Swatantara21/Bulk_Encryptor/README.md

# Bulk_Encryptor
Contributors:
Madhav P. Desai
Anshul Gupta
Swatantara Chakraborty

Try to get this goddamned piece of crap into 
some reasonable shape.

All stuff is placed in reoorg.
