Swatantara21/Bulk_Encryptor/riffa_testbench/test_threads2/readme.txt

riffa testbench :
creats two threads, one supplies two 64-bits inputs numWords times
and other recieves two 64-bits output numWords times.
numWords is given while running the executable "testutil"
