Swatantara21/Bulk_Encryptor/riffa_testbench/readme.txt

This folder contains riffa testbenches..
