Swatantara21/Bulk_Encryptor/Aes-Reorg/riffa_testbench/readme.txt

aes_avs_test/

	A testbench which checks the AESAVS from NIST on
	our implementation.
