Swatantara21/Bulk_Encryptor/riffa_testbench/test_apps/readme.txt

riffa testbench by riffa creators.
for bandwidth tests on fpga
