Swatantara21/Bulk_Encryptor/Aes-Reorg/riffa_testbench/aes_avs_test/readme.txt

riffa testbench :
supplies two 64-bit inputs and recieves of two 64-bits output serially numWords times.
numWords is given while running the executable "testutil"
