Swatantara21/Bulk_Encryptor/aes_blocks/e_block_volatile/test_result.txt

3ad78e726c1ec02b 7ebfe92b23d9ec34
aae5939c8efdf2f0 4e60b9fe7117b2c2
f031d4d74f5dcbf3 9daaf8ca3af6e527
96d9fd5cc4f07441 727df0f33e401a36
30ccdb044646d7e1 f3ccea3dca08b8c0
16ae4ce5042a67ee 8e177b7c587ecc82
b6da0bb11a23855d 9c5cb1b4c6412e0a
db4f1aa530967d67 32ce4715eb0ee24b
a81738252621dd18  a34f3455b4baa2f
77e2b508db7fd892 34caf7939ee5621a
b8499c251f8442ee 13f0933b688fcd19
965135f8a81f25c9 d630b17502f68e53
8b87145a01ad1c6c ede995ea3670454f
8eae3b10a0c8ca6d 1d3b0fa61e56b0b2
64b4d629810fda6b afdf08f3b0d8d2c5
