Swatantara21/Bulk_Encryptor/Aes-Reorg/aes_engine/Aa/testbench_mc.txt

#include <signal.h>
#include <stdio.h>
#include <stdlib.h>
#include <stdint.h>
#include <pthread.h>
#include <pthreadUtils.h>
#include <Pipes.h>
#include <pipeHandler.h>
#ifndef SW
#include "vhdlCStubs.h"
#endif

#define ORDER 128

uint64_t sent_values[2];
uint64_t cmd_values[3];
void Exit(int sig)
{
	fprintf(stderr, "## Break! ##\n");
	exit(0);
}

void SenderCmd()
{
	int idx,jdx,k;
	cmd_values[0] = 0x880000000000000a;
	cmd_values[1] = 0x0000000000000000;
	cmd_values[2] = 0x0000000000000000;
	
	write_uint64_n("cmd_in",cmd_values,3);
	fprintf(stderr,"\ncmd: %16lx key:%16lx %16lx",cmd_values[0],cmd_values[1],cmd_values[2]);
	
	cmd_values[0] = 0x880000000000002a;
	cmd_values[1] = 0x0000000000000000;
	cmd_values[2] = 0x0000000000000001;
	write_uint64_n("cmd_in",cmd_values,3);
	fprintf(stderr,"\ncmd: %16lx key:%16lx %16lx",cmd_values[0],cmd_values[1],cmd_values[2]);
	
}

void Sender()
{
	int idx,jdx,k;
	k=0;
	sent_values[0] = 0x8000000000000000;
	sent_values[1] = 0x0000000000000000;
	
	write_uint64_n("in_data",sent_values,2);
	fprintf(stderr,"\nPT: %16lx %16lx",sent_values[0],sent_values[1]);
	
	for(idx = 1; idx < ORDER; idx++)
	{	
		if(sent_values[k]==0xffffffffffffffff){
			k++;
			sent_values[k]= 0x8000000000000000;
		}
		else
			sent_values[k] = sent_values[k]|(sent_values[k]/2);
			
		write_uint64_n("in_data",sent_values,2);
		fprintf(stdout,"\nPT: %d: %16lx %16lx",idx,sent_values[0],sent_values[1]);
	}
	
}

void RecvStatus(){
	uint64_t status;
	while (1){
	status = read_uint64("status_out");
	fprintf(stdout,"\nstatus: %16lx\n", status);
	}
}

DEFINE_THREAD(Sender)
DEFINE_THREAD(SenderCmd)
DEFINE_THREAD(RecvStatus)

int main(int argc, char* argv[])
{	
	uint64_t result[2];
	signal(SIGINT,  Exit);
  	signal(SIGTERM, Exit);

	PTHREAD_DECL(RecvStatus);
	PTHREAD_CREATE(RecvStatus);

	int i,j,idx, jdx;
	
	cmd_values[0] = 0x880000000000000a;
	cmd_values[1] = 0x8d2e60365f17c7df;
	cmd_values[2] = 0x1040d7501b4a7b5a;
	
	sent_values[0] = 0x59b5088e6dadc3ad;
	sent_values[1] = 0x5f27a460872d5929;
	
	for (i=0; i<5; i++){
		fprintf(stderr,"cmd: %16lx key:%16lx %16lx\n",cmd_values[0],cmd_values[1],cmd_values[2]);
		fprintf(stdout,"\nPT: %d: %16lx %16lx",idx,sent_values[0],sent_values[1]);
		write_uint64_n("cmd_in",cmd_values,3);
	
		for (j=0; j<10; j++){
			write_uint64_n("d_in_data",sent_values,2);
			read_uint64_n("d_out_data",result,2);
			sent_values[0] = result[0];
			sent_values[1] = result[1];
		}
		fprintf(stdout,"\nCT: %d: %16lx%16lx",idx, result[0],result[1]);
		cmd_values[1] = cmd_values[1] ^ result[0];
		cmd_values[2] = cmd_values[0] ^ result[1];
	}
		
	PTHREAD_CANCEL(RecvStatus);
	return(0);
}
