Swatantara21/Bulk_Encryptor/c_aes/decryption/KAT2/aa_result_ch512.txt

7636b952aea4d79f16d5cc3f05fdc0fa
883816ecc11a3eff710036994f8a34f3
0e384f0ea9d1bae775bf35cb768d07ff
3f458867758e0fe51cbb01df9d02817b
6e30570bfe38a2c10f8439f3ef09974b
59e070209e79ff04d712f8f2b3e90dba
b74689f5de03072cd42e12711c321c79
5e6117ee1740769bd94dc84cfd1e081b
c5ac0a45c9a74d8d039bb3d4c9c087c4
e8b694c777a9885e62f583503a543eda
514572af03f1c0657bc952b73c4867af
2c0bcc4a2590ecccf3bf8e58e3b78cab
4a3bf1e096c174dc6c44a0a2e2478f21
a4558821e514467705cb8f6e59dde874
c27f4370aa8a854888a9898030469665
ebb905da478a62753c4cc469732ba1b9
a86ab86bb6ddf3b7680bd1fefd4622fc
8d3b04adf60d6b08e94c79246ed0f092
c2c335e4ec32cc90245a17d8812a0874
fc11699a3bd24236e860e682b0b83c51
1cdd389b25f4b9d7ee3196f4abe3ca05
90f45b62e085c20c375b40df811ce9f6
9913a19415809f45fa6ea4a642c09a25
6dc85c175ce262f807adde557b4bdd48
9cf519ba3fdd180098ba9a172dc7ff60
22f69a38f3dde85e1f0a0b61ecd9cc0e
a1ba632631f2697c3190c3ae5f01c938
a4c331b446a9a065257a0e17a62e3332
f73d74aa2733cee2c71fb01679eb3729
db49f30395736abe7794470f616867e6
95bdca13354c0602139052a68e8f0b63
9e8bcbc935b23f4110957eb237103040
65367f0daaf61bb7951977422f8f9cd2
5b0dee708b299485db85995259e7a9f1
310c7d74ca3395ecca4df26118342bc3
29734d6b167c314f308098a2bf8cf85c
bb841748a574f579c26d6b9764bd14e8
79fcfecebf4d9326cc0a159183dde541
c02128f3ba397b3817ed737bc9d158bb
76fc64a8ba88d947928192f6d79440e9
68b18496793bd9ad097ffbfc40515a17
7c3d44099bf62e4117156a0945852068
83490d2b32c22085f7f694273fa1ae3a
53bb619830e22c943758cebf6e3a8f9d
08bdf0c088fe549b1d0a256737e7c3dc
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
ab975a6e0e7944bbcd4375392f3bb61e
c0956776d400a1aec02e317553035bd8
d38ef6a5a6120fbc3c5290145c2e75de
1513dda91244abb0511e64f53b6e57fa
09340b8073dfbd03cf9664a801831a64
cdef9e2a34f2a8b40468165f429d4466
6aae85d60d8193314e2f4ee761e538e9
0e14ecf1d401daf978f807bfcb8beb0e
726f79b49a1d8f0f0937b42338d22b9c
