Swatantara21/Bulk_Encryptor/Aes-Reorg/bitfilegen/tcl250/.Xil/PCIeGen1x8If64_propImpl.xdc

set_property SRC_FILE_INFO {cfile:/home/anshul/Aes-Reorg/bitfilegen/ip/pcie_core/source/PCIeGen1x8If64-PCIE_X0Y0.xdc rfile:../../ip/pcie_core/source/PCIeGen1x8If64-PCIE_X0Y0.xdc id:1 order:EARLY scoped_inst:inst} [current_design]
set_property src_info {type:SCOPED_XDC file:1 line:79 export:INPUT save:INPUT read:READ} [current_design]
set_property LOC GTXE2_CHANNEL_X0Y7 [get_cells {inst/gt_top_i/pipe_wrapper_i/pipe_lane[0].gt_wrapper_i/gtx_channel.gtxe2_channel_i}]
set_property src_info {type:SCOPED_XDC file:1 line:81 export:INPUT save:INPUT read:READ} [current_design]
set_property LOC GTXE2_CHANNEL_X0Y6 [get_cells {inst/gt_top_i/pipe_wrapper_i/pipe_lane[1].gt_wrapper_i/gtx_channel.gtxe2_channel_i}]
set_property src_info {type:SCOPED_XDC file:1 line:83 export:INPUT save:INPUT read:READ} [current_design]
set_property LOC GTXE2_CHANNEL_X0Y5 [get_cells {inst/gt_top_i/pipe_wrapper_i/pipe_lane[2].gt_wrapper_i/gtx_channel.gtxe2_channel_i}]
set_property src_info {type:SCOPED_XDC file:1 line:85 export:INPUT save:INPUT read:READ} [current_design]
set_property LOC GTXE2_CHANNEL_X0Y4 [get_cells {inst/gt_top_i/pipe_wrapper_i/pipe_lane[3].gt_wrapper_i/gtx_channel.gtxe2_channel_i}]
set_property src_info {type:SCOPED_XDC file:1 line:87 export:INPUT save:INPUT read:READ} [current_design]
set_property LOC GTXE2_CHANNEL_X0Y3 [get_cells {inst/gt_top_i/pipe_wrapper_i/pipe_lane[4].gt_wrapper_i/gtx_channel.gtxe2_channel_i}]
set_property src_info {type:SCOPED_XDC file:1 line:89 export:INPUT save:INPUT read:READ} [current_design]
set_property LOC GTXE2_CHANNEL_X0Y2 [get_cells {inst/gt_top_i/pipe_wrapper_i/pipe_lane[5].gt_wrapper_i/gtx_channel.gtxe2_channel_i}]
set_property src_info {type:SCOPED_XDC file:1 line:91 export:INPUT save:INPUT read:READ} [current_design]
set_property LOC GTXE2_CHANNEL_X0Y1 [get_cells {inst/gt_top_i/pipe_wrapper_i/pipe_lane[6].gt_wrapper_i/gtx_channel.gtxe2_channel_i}]
set_property src_info {type:SCOPED_XDC file:1 line:93 export:INPUT save:INPUT read:READ} [current_design]
set_property LOC GTXE2_CHANNEL_X0Y0 [get_cells {inst/gt_top_i/pipe_wrapper_i/pipe_lane[7].gt_wrapper_i/gtx_channel.gtxe2_channel_i}]
set_property src_info {type:SCOPED_XDC file:1 line:101 export:INPUT save:INPUT read:READ} [current_design]
set_property LOC PCIE_X0Y0 [get_cells inst/pcie_top_i/pcie_7x_i/pcie_block_i]
set_property src_info {type:SCOPED_XDC file:1 line:106 export:INPUT save:INPUT read:READ} [current_design]
set_property LOC RAMB36_X4Y34 [get_cells {inst/pcie_top_i/pcie_7x_i/pcie_bram_top/pcie_brams_rx/brams[0].ram/use_tdp.ramb36/genblk*.bram36_tdp_bl.bram36_tdp_bl}]
set_property src_info {type:SCOPED_XDC file:1 line:107 export:INPUT save:INPUT read:READ} [current_design]
set_property LOC RAMB36_X4Y33 [get_cells {inst/pcie_top_i/pcie_7x_i/pcie_bram_top/pcie_brams_rx/brams[1].ram/use_tdp.ramb36/genblk*.bram36_tdp_bl.bram36_tdp_bl}]
set_property src_info {type:SCOPED_XDC file:1 line:108 export:INPUT save:INPUT read:READ} [current_design]
set_property LOC RAMB36_X4Y31 [get_cells {inst/pcie_top_i/pcie_7x_i/pcie_bram_top/pcie_brams_tx/brams[0].ram/use_tdp.ramb36/genblk*.bram36_tdp_bl.bram36_tdp_bl}]
set_property src_info {type:SCOPED_XDC file:1 line:109 export:INPUT save:INPUT read:READ} [current_design]
set_property LOC RAMB36_X4Y30 [get_cells {inst/pcie_top_i/pcie_7x_i/pcie_bram_top/pcie_brams_tx/brams[1].ram/use_tdp.ramb36/genblk*.bram36_tdp_bl.bram36_tdp_bl}]
