Swatantara21/Bulk_Encryptor/Aes-Reorg/bitfilegen/tcl250/.Xil/Vivado-4576-AJIT6/realtime/PCIeGen1x8If64_synth.xdc

set_property SRC_FILE_INFO {cfile:/home/anshul/fpga/bitfilegeneration/ip/pcie_core/synth/PCIeGen1x8If64_ooc.xdc rfile:../../../../ip/pcie_core/synth/PCIeGen1x8If64_ooc.xdc id:1 order:EARLY scoped_inst:inst} [current_design]
set_property SRC_FILE_INFO {cfile:/home/anshul/fpga/bitfilegeneration/ip/pcie_core/source/PCIeGen1x8If64-PCIE_X0Y0.xdc rfile:../../../../ip/pcie_core/source/PCIeGen1x8If64-PCIE_X0Y0.xdc id:2 order:EARLY scoped_inst:inst} [current_design]
set_property src_info {type:TCL file:{} line:-1 export:INPUT save:INPUT read:READ} [current_design]
set_property DONT_TOUCH true [get_cells inst]
set_property src_info {type:SCOPED_XDC file:1 line:60 export:INPUT save:INPUT read:FILTER_OUT_OF_CONTEXT} [current_design]
create_clock -period 10.000 -name PCIeGen1x8If64_sys_clk [get_ports sys_clk]
current_instance inst
set_property src_info {type:SCOPED_XDC file:2 line:115 export:INPUT save:INPUT read:READ} [current_design]
create_clock -period 10.000 -name inst/inst/gt_top_i/pipe_wrapper_i/pipe_lane[0].gt_wrapper_i/gtx_channel.gtxe2_channel_i/TXOUTCLK [get_pins {inst/gt_top_i/pipe_wrapper_i/pipe_lane[0].gt_wrapper_i/gtx_channel.gtxe2_channel_i/TXOUTCLK}]
set_property src_info {type:SCOPED_XDC file:2 line:118 export:INPUT save:INPUT read:READ} [current_design]
set_false_path -to [get_pins inst/gt_top_i/pipe_wrapper_i/pipe_clock_int.pipe_clock_i/pclk_i1_bufgctrl.pclk_i1/S0]
set_property src_info {type:SCOPED_XDC file:2 line:119 export:INPUT save:INPUT read:READ} [current_design]
set_false_path -to [get_pins inst/gt_top_i/pipe_wrapper_i/pipe_clock_int.pipe_clock_i/pclk_i1_bufgctrl.pclk_i1/S1]
set_property src_info {type:SCOPED_XDC file:2 line:122 export:INPUT save:INPUT read:READ} [current_design]
set_case_analysis 1 [get_pins inst/gt_top_i/pipe_wrapper_i/pipe_clock_int.pipe_clock_i/pclk_i1_bufgctrl.pclk_i1/S0]
set_property src_info {type:SCOPED_XDC file:2 line:123 export:INPUT save:INPUT read:READ} [current_design]
set_case_analysis 0 [get_pins inst/gt_top_i/pipe_wrapper_i/pipe_clock_int.pipe_clock_i/pclk_i1_bufgctrl.pclk_i1/S1]
set_property src_info {type:SCOPED_XDC file:2 line:130 export:INPUT save:INPUT read:READ} [current_design]
set_false_path -through [get_pins inst/pcie_top_i/pcie_7x_i/pcie_block_i/PLPHYLNKUPN]
set_property src_info {type:SCOPED_XDC file:2 line:131 export:INPUT save:INPUT read:READ} [current_design]
set_false_path -through [get_pins inst/pcie_top_i/pcie_7x_i/pcie_block_i/PLRECEIVEDHOTRST]
current_instance
set_property src_info {type:PI file:{} line:-1 export:INPUT save:INPUT read:READ} [current_design]
create_generated_clock -name mmcm_fb -source [get_pins inst/inst/gt_top_i/pipe_wrapper_i/pipe_clock_int.pipe_clock_i/mmcm_i/CLKIN1] -multiply_by 1 -add -master_clock inst/inst/gt_top_i/pipe_wrapper_i/pipe_lane[0].gt_wrapper_i/gtx_channel.gtxe2_channel_i/TXOUTCLK [get_pins inst/inst/gt_top_i/pipe_wrapper_i/pipe_clock_int.pipe_clock_i/mmcm_i/CLKFBOUT]
set_property src_info {type:PI file:{} line:-1 export:INPUT save:INPUT read:READ} [current_design]
create_generated_clock -name clk_125mhz -source [get_pins inst/inst/gt_top_i/pipe_wrapper_i/pipe_clock_int.pipe_clock_i/mmcm_i/CLKIN1] -edges {1 2 3} -edge_shift {0.000 -1.000 -2.000} -add -master_clock inst/inst/gt_top_i/pipe_wrapper_i/pipe_lane[0].gt_wrapper_i/gtx_channel.gtxe2_channel_i/TXOUTCLK [get_pins inst/inst/gt_top_i/pipe_wrapper_i/pipe_clock_int.pipe_clock_i/mmcm_i/CLKOUT0]
set_property src_info {type:PI file:{} line:-1 export:INPUT save:INPUT read:READ} [current_design]
create_generated_clock -name clk_250mhz -source [get_pins inst/inst/gt_top_i/pipe_wrapper_i/pipe_clock_int.pipe_clock_i/mmcm_i/CLKIN1] -edges {1 2 3} -edge_shift {0.000 -3.000 -6.000} -add -master_clock inst/inst/gt_top_i/pipe_wrapper_i/pipe_lane[0].gt_wrapper_i/gtx_channel.gtxe2_channel_i/TXOUTCLK [get_pins inst/inst/gt_top_i/pipe_wrapper_i/pipe_clock_int.pipe_clock_i/mmcm_i/CLKOUT1]
set_property src_info {type:PI file:{} line:-1 export:INPUT save:INPUT read:READ} [current_design]
create_generated_clock -name userclk1 -source [get_pins inst/inst/gt_top_i/pipe_wrapper_i/pipe_clock_int.pipe_clock_i/mmcm_i/CLKIN1] -edges {1 2 3} -edge_shift {0.000 -3.000 -6.000} -add -master_clock inst/inst/gt_top_i/pipe_wrapper_i/pipe_lane[0].gt_wrapper_i/gtx_channel.gtxe2_channel_i/TXOUTCLK [get_pins inst/inst/gt_top_i/pipe_wrapper_i/pipe_clock_int.pipe_clock_i/mmcm_i/CLKOUT2]
