Swatantara21/Bulk_Encryptor/Aes-Reorg/bitfilegen/ip/pcie_core/source/PCIeGen1x8If64_axi_basic_rx_pipeline.v

//-----------------------------------------------------------------------------
//
// (c) Copyright 2010-2011 Xilinx, Inc. All rights reserved.
//
// This file contains confidential and proprietary information
// of Xilinx, Inc. and is protected under U.S. and
// international copyright and other intellectual property
// laws.
//
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
// CRITICAL APPLICATIONS
// Xilinx products are not designed or intended to be fail-
// safe, or for use in any application requiring fail-safe
// performance, such as life-support or safety devices or
// systems, Class III medical devices, nuclear facilities,
// applications related to the deployment of airbags, or any
// other applications that could lead to death, personal
// injury, or severe property or environmental damage
// (individually and collectively, "Critical
// Applications"). Customer assumes the sole risk and
// liability of any use of Xilinx products in Critical
// Applications, subject only to applicable laws and
// regulations governing limitations on product liability.
//
// THIS COPYRIGHT NOTICE AND DISCLAIMER MUST BE RETAINED AS
// PART OF THIS FILE AT ALL TIMES.
//
//-----------------------------------------------------------------------------
// Project    : Series-7 Integrated Block for PCI Express
// File       : PCIeGen1x8If64_axi_basic_rx_pipeline.v
// Version    : 3.0
//                                                                            //
//  Description:                                                              //
//  TRN to AXI RX pipeline. Converts received data from TRN protocol to AXI.  //
//                                                                            //
//  Notes:                                                                    //
//  Optional notes section.                                                   //
//                                                                            //
//  Hierarchical:                                                             //
//    axi_basic_top                                                           //
//      axi_basic_rx                                                          //
//        axi_basic_rx_pipeline                                               //
//                                                                            //
//----------------------------------------------------------------------------//

`timescale 1ps/1ps

(* DowngradeIPIdentifiedWarnings = "yes" *)
module PCIeGen1x8If64_axi_basic_rx_pipeline #(
  parameter C_DATA_WIDTH = 128,           // RX/TX interface data width
  parameter C_FAMILY     = "X7",          // Targeted FPGA family
  parameter TCQ = 1,                      // Clock to Q time

  // Do not override parameters below this line
  parameter REM_WIDTH  = (C_DATA_WIDTH == 128) ? 2 : 1, // trem/rrem width
  parameter KEEP_WIDTH = C_DATA_WIDTH / 8               // KEEP width
  ) (

  // AXI RX
  //-----------
  output reg [C_DATA_WIDTH-1:0] m_axis_rx_tdata,     // RX data to user
  output reg                    m_axis_rx_tvalid,    // RX data is valid
  input                         m_axis_rx_tready,    // RX ready for data
  output       [KEEP_WIDTH-1:0] m_axis_rx_tkeep,     // RX strobe byte enables
  output                        m_axis_rx_tlast,     // RX data is last
  output reg             [21:0] m_axis_rx_tuser,     // RX user signals

  // TRN RX
  //-----------
  input      [C_DATA_WIDTH-1:0] trn_rd,              // RX data from block
  input                         trn_rsof,            // RX start of packet
  input                         trn_reof,            // RX end of packet
  input                         trn_rsrc_rdy,        // RX source ready
  output reg                    trn_rdst_rdy,        // RX destination ready
  input                         trn_rsrc_dsc,        // RX source discontinue
  input         [REM_WIDTH-1:0] trn_rrem,            // RX remainder
  input                         trn_rerrfwd,         // RX error forward
  input                   [6:0] trn_rbar_hit,        // RX BAR hit
  input                         trn_recrc_err,       // RX ECRC error

  // Null Inputs
  //-----------
  input                         null_rx_tvalid,      // NULL generated tvalid
  input                         null_rx_tlast,       // NULL generated tlast
  input        [KEEP_WIDTH-1:0] null_rx_tkeep,       // NULL generated tkeep
  input                         null_rdst_rdy,       // NULL generated rdst_rdy
  input                   [4:0] null_is_eof,         // NULL generated is_eof

  // System
  //-----------
  output                  [2:0] np_counter,          // Non-posted counter
  input                         user_clk,            // user clock from block
  input                         user_rst             // user reset from block
);


// Wires and regs for creating AXI signals
wire              [4:0] is_sof;
wire              [4:0] is_sof_prev;

wire              [4:0] is_eof;
wire              [4:0] is_eof_prev;

reg    [KEEP_WIDTH-1:0] reg_tkeep;
wire   [KEEP_WIDTH-1:0] tkeep;
wire   [KEEP_WIDTH-1:0] tkeep_prev;

reg                     reg_tlast;
wire                    rsrc_rdy_filtered;

// Wires and regs for previous value buffer
wire [C_DATA_WIDTH-1:0] trn_rd_DW_swapped;
reg  [C_DATA_WIDTH-1:0] trn_rd_prev;

wire                    data_hold;
reg                     data_prev;

reg                     trn_reof_prev;
reg     [REM_WIDTH-1:0] trn_rrem_prev;
reg                     trn_rsrc_rdy_prev;
reg                     trn_rsrc_dsc_prev;
reg                     trn_rsof_prev;
reg               [6:0] trn_rbar_hit_prev;
reg                     trn_rerrfwd_prev;
reg                     trn_recrc_err_prev;

// Null packet handling signals
reg                     null_mux_sel;
reg                     trn_in_packet;
wire                    dsc_flag;
wire                    dsc_detect;
reg                     reg_dsc_detect;
reg                     trn_rsrc_dsc_d;


// Create "filtered" version of rsrc_rdy, where discontinued SOFs are removed.
assign rsrc_rdy_filtered = trn_rsrc_rdy &&
                                 (trn_in_packet || (trn_rsof && !trn_rsrc_dsc));

//----------------------------------------------------------------------------//
// Previous value buffer                                                      //
// ---------------------                                                      //
// We are inserting a pipeline stage in between TRN and AXI, which causes     //
// some issues with handshaking signals m_axis_rx_tready/trn_rdst_rdy. The    //
// added cycle of latency in the path causes the user design to fall behind   //
// the TRN interface whenever it throttles.                                   //
//                                                                            //
// To avoid loss of data, we must keep the previous value of all trn_r*       //
// signals in case the user throttles.                                        //
//----------------------------------------------------------------------------//
always @(posedge user_clk) begin
  if(user_rst) begin
    trn_rd_prev        <= #TCQ {C_DATA_WIDTH{1'b0}};
    trn_rsof_prev      <= #TCQ 1'b0;
    trn_rrem_prev      <= #TCQ {REM_WIDTH{1'b0}};
    trn_rsrc_rdy_prev  <= #TCQ 1'b0;
    trn_rbar_hit_prev  <= #TCQ 7'h00;
    trn_rerrfwd_prev   <= #TCQ 1'b0;
    trn_recrc_err_prev <= #TCQ 1'b0;
    trn_reof_prev      <= #TCQ 1'b0;
    trn_rsrc_dsc_prev  <= #TCQ 1'b0;
  end
  else begin
    // prev buffer works by checking trn_rdst_rdy. When trn_rdst_rdy is
    // asserted, a new value is present on the interface.
    if(trn_rdst_rdy) begin
      trn_rd_prev        <= #TCQ trn_rd_DW_swapped;
      trn_rsof_prev      <= #TCQ trn_rsof;
      trn_rrem_prev      <= #TCQ trn_rrem;
      trn_rbar_hit_prev  <= #TCQ trn_rbar_hit;
      trn_rerrfwd_prev   <= #TCQ trn_rerrfwd;
      trn_recrc_err_prev <= #TCQ trn_recrc_err;
      trn_rsrc_rdy_prev  <= #TCQ rsrc_rdy_filtered;
      trn_reof_prev      <= #TCQ trn_reof;
      trn_rsrc_dsc_prev  <= #TCQ trn_rsrc_dsc || dsc_flag;
    end
  end
end


//----------------------------------------------------------------------------//
// Create TDATA                                                               //
//----------------------------------------------------------------------------//

// Convert TRN data format to AXI data format. AXI is DWORD swapped from TRN
// 128-bit:                 64-bit:                  32-bit:
// TRN DW0 maps to AXI DW3  TRN DW0 maps to AXI DW1  TNR DW0 maps to AXI DW0
// TRN DW1 maps to AXI DW2  TRN DW1 maps to AXI DW0
// TRN DW2 maps to AXI DW1
// TRN DW3 maps to AXI DW0
generate
  if(C_DATA_WIDTH == 128) begin : rd_DW_swap_128
    assign trn_rd_DW_swapped = {trn_rd[31:0],
                                trn_rd[63:32],
                                trn_rd[95:64],
                                trn_rd[127:96]};
  end
  else if(C_DATA_WIDTH == 64) begin : rd_DW_swap_64
    assign trn_rd_DW_swapped = {trn_rd[31:0], trn_rd[63:32]};
  end
  else begin : rd_DW_swap_32
    assign trn_rd_DW_swapped = trn_rd;
  end
endgenerate


// Create special buffer which locks in the proper value of TDATA depending
// on whether the user is throttling or not. This buffer has three states:
//
//       HOLD state: TDATA maintains its current value
//                   - the user has throttled the PCIe block
//   PREVIOUS state: the buffer provides the previous value on trn_rd
//                   - the user has finished throttling, and is a little behind
//                     the PCIe block
//    CURRENT state: the buffer passes the current value on trn_rd
//                   - the user is caught up and ready to receive the latest
//                     data from the PCIe block
always @(posedge user_clk) begin
  if(user_rst) begin
    m_axis_rx_tdata <= #TCQ {C_DATA_WIDTH{1'b0}};
  end
  else begin
    if(!data_hold) begin
      // PREVIOUS state
      if(data_prev) begin
        m_axis_rx_tdata <= #TCQ trn_rd_prev;
      end

      // CURRENT state
      else begin
        m_axis_rx_tdata <= #TCQ trn_rd_DW_swapped;
      end
    end
    // else HOLD state
  end
end

// Logic to instruct pipeline to hold its value
assign data_hold = (!m_axis_rx_tready && m_axis_rx_tvalid);

// Logic to instruct pipeline to use previous bus values. Always use previous
// value after holding a value.
always @(posedge user_clk) begin
  if(user_rst) begin
    data_prev <= #TCQ 1'b0;
  end
  else begin
    data_prev <= #TCQ data_hold;
  end
end


//----------------------------------------------------------------------------//
// Create TVALID, TLAST, tkeep, TUSER                                         //
// -----------------------------------                                        //
// Use the same strategy for these signals as for TDATA, except here we need  //
// an extra provision for null packets.                                       //
//----------------------------------------------------------------------------//
always @(posedge user_clk) begin
  if(user_rst) begin
    m_axis_rx_tvalid <= #TCQ 1'b0;
    reg_tlast        <= #TCQ 1'b0;
    reg_tkeep        <= #TCQ {KEEP_WIDTH{1'b1}};
    m_axis_rx_tuser  <= #TCQ 22'h0;
  end
  else begin
    if(!data_hold) begin
      // If in a null packet, use null generated value
      if(null_mux_sel) begin
        m_axis_rx_tvalid <= #TCQ null_rx_tvalid;
        reg_tlast        <= #TCQ null_rx_tlast;
        reg_tkeep        <= #TCQ null_rx_tkeep;
        m_axis_rx_tuser  <= #TCQ {null_is_eof, 17'h0000};
      end

      // PREVIOUS state
      else if(data_prev) begin
        m_axis_rx_tvalid <= #TCQ (trn_rsrc_rdy_prev || dsc_flag);
        reg_tlast        <= #TCQ trn_reof_prev;
        reg_tkeep        <= #TCQ tkeep_prev;
        m_axis_rx_tuser  <= #TCQ {is_eof_prev,          // TUSER bits [21:17]
                                  2'b00,                // TUSER bits [16:15]
                                  is_sof_prev,          // TUSER bits [14:10]
                                  1'b0,                 // TUSER bit  [9]
                                  trn_rbar_hit_prev,    // TUSER bits [8:2]
                                  trn_rerrfwd_prev,     // TUSER bit  [1]
                                  trn_recrc_err_prev};  // TUSER bit  [0]
      end

      // CURRENT state
      else begin
        m_axis_rx_tvalid <= #TCQ (rsrc_rdy_filtered || dsc_flag);
        reg_tlast        <= #TCQ trn_reof;
        reg_tkeep        <= #TCQ tkeep;
        m_axis_rx_tuser  <= #TCQ {is_eof,               // TUSER bits [21:17]
                                  2'b00,                // TUSER bits [16:15]
                                  is_sof,               // TUSER bits [14:10]
                                  1'b0,                 // TUSER bit  [9]
                                  trn_rbar_hit,         // TUSER bits [8:2]
                                  trn_rerrfwd,          // TUSER bit  [1]
                                  trn_recrc_err};       // TUSER bit  [0]
      end
    end
    // else HOLD state
  end
end

// Hook up TLAST and tkeep depending on interface width
generate
  // For 128-bit interface, don't pass TLAST and tkeep to user (is_eof and
  // is_data passed to user instead). reg_tlast is still used internally.
  if(C_DATA_WIDTH == 128) begin : tlast_tkeep_hookup_128
    assign m_axis_rx_tlast = 1'b0;
    assign m_axis_rx_tkeep = {KEEP_WIDTH{1'b1}};
  end

  // For 64/32-bit interface, pass TLAST to user.
  else begin : tlast_tkeep_hookup_64_32
    assign m_axis_rx_tlast = reg_tlast;
    assign m_axis_rx_tkeep = reg_tkeep;
  end
endgenerate


//----------------------------------------------------------------------------//
// Create tkeep                                                               //
// ------------                                                               //
// Convert RREM to STRB. Here, we are converting the encoding method for the  //
// location of the EOF from TRN flavor (rrem) to AXI (tkeep).                 //
//                                                                            //
// NOTE: for each configuration, we need two values of tkeep, the current and //
//       previous values. The need for these two values is described below.   //
//----------------------------------------------------------------------------//
generate
  if(C_DATA_WIDTH == 128) begin : rrem_to_tkeep_128
    // TLAST and tkeep not used in 128-bit interface. is_sof and is_eof used
    // instead.
    assign tkeep      = 16'h0000;
    assign tkeep_prev = 16'h0000;
  end
  else if(C_DATA_WIDTH == 64) begin : rrem_to_tkeep_64
    // 64-bit interface: contains 2 DWORDs per cycle, for a total of 8 bytes
    //  - tkeep has only two possible values here, 0xFF or 0x0F
    assign tkeep      = trn_rrem      ? 8'hFF : 8'h0F;
    assign tkeep_prev = trn_rrem_prev ? 8'hFF : 8'h0F;
  end
  else begin : rrem_to_tkeep_32
    // 32-bit interface: contains 1 DWORD per cycle, for a total of 4 bytes
    //  - tkeep is always 0xF in this case, due to the nature of the PCIe block
    assign tkeep      = 4'hF;
    assign tkeep_prev = 4'hF;
  end
endgenerate


//----------------------------------------------------------------------------//
// Create is_sof                                                              //
// -------------                                                              //
// is_sof is a signal to the user indicating the location of SOF in TDATA   . //
// Due to inherent 64-bit alignment of packets from the block, the only       //
// possible values are:                                                       //
//                      Value                      Valid data widths          //
//                      5'b11000 (sof @ byte 8)    128                        //
//                      5'b10000 (sof @ byte 0)    128, 64, 32                //
//                      5'b00000 (sof not present) 128, 64, 32                //
//----------------------------------------------------------------------------//
generate
  if(C_DATA_WIDTH == 128) begin : is_sof_128
    assign is_sof      = {(trn_rsof && !trn_rsrc_dsc), // bit 4:   enable
                          (trn_rsof && !trn_rrem[1]),  // bit 3:   sof @ byte 8?
                          3'b000};                     // bit 2-0: hardwired 0

    assign is_sof_prev = {(trn_rsof_prev && !trn_rsrc_dsc_prev), // bit 4
                          (trn_rsof_prev && !trn_rrem_prev[1]),  // bit 3
                          3'b000};                               // bit 2-0
  end
  else begin : is_sof_64_32
    assign is_sof      = {(trn_rsof && !trn_rsrc_dsc), // bit 4:   enable
                          4'b0000};                    // bit 3-0: hardwired 0

    assign is_sof_prev = {(trn_rsof_prev && !trn_rsrc_dsc_prev), // bit 4
                          4'b0000};                              // bit 3-0
  end
endgenerate


//----------------------------------------------------------------------------//
// Create is_eof                                                              //
// -------------                                                              //
// is_eof is a signal to the user indicating the location of EOF in TDATA   . //
// Due to DWORD granularity of packets from the block, the only               //
// possible values are:                                                       //
//                      Value                      Valid data widths          //
//                      5'b11111 (eof @ byte 15)   128                        //
//                      5'b11011 (eof @ byte 11)   128                        //
//                      5'b10111 (eof @ byte 7)    128, 64                    //
//                      5'b10011 (eof @ byte 3)`   128, 64, 32                //
//                      5'b00011 (eof not present) 128, 64, 32                //
//----------------------------------------------------------------------------//
generate
  if(C_DATA_WIDTH == 128) begin : is_eof_128
    assign is_eof      = {trn_reof,      // bit 4:   enable
                          trn_rrem,      // bit 3-2: encoded eof loc rom block
                          2'b11};        // bit 1-0: hardwired 1

    assign is_eof_prev = {trn_reof_prev, // bit 4:   enable
                          trn_rrem_prev, // bit 3-2: encoded eof loc from block
                          2'b11};        // bit 1-0: hardwired 1
  end
  else if(C_DATA_WIDTH == 64) begin : is_eof_64
    assign is_eof      = {trn_reof,      // bit 4:   enable
                          1'b0,          // bit 3:   hardwired 0
                          trn_rrem,      // bit 2:   encoded eof loc from block
                          2'b11};        // bit 1-0: hardwired 1

    assign is_eof_prev = {trn_reof_prev, // bit 4:   enable
                          1'b0,          // bit 3:   hardwired 0
                          trn_rrem_prev, // bit 2:   encoded eof loc from block
                          2'b11};        // bit 1-0: hardwired 1
  end
  else begin : is_eof_32
    assign is_eof      = {trn_reof,      // bit 4:   enable
                          4'b0011};      // bit 3-0: hardwired to byte 3

    assign is_eof_prev = {trn_reof_prev, // bit 4:   enable
                          4'b0011};      // bit 3-0: hardwired to byte 3
  end
endgenerate



//----------------------------------------------------------------------------//
// Create trn_rdst_rdy                                                        //
//----------------------------------------------------------------------------//
always @(posedge user_clk) begin
  if(user_rst) begin
    trn_rdst_rdy <= #TCQ 1'b0;
  end
  else begin
    // If in a null packet, use null generated value
    if(null_mux_sel && m_axis_rx_tready) begin
      trn_rdst_rdy <= #TCQ null_rdst_rdy;
    end

    // If a discontinue needs to be serviced, throttle the block until we are
    // ready to pad out the packet.
    else if(dsc_flag) begin
      trn_rdst_rdy <= #TCQ 1'b0;
    end

    // If in a packet, pass user back-pressure directly to block
    else if(m_axis_rx_tvalid) begin
      trn_rdst_rdy <= #TCQ m_axis_rx_tready;
    end

    // If idle, default to no back-pressure. We need to default to the
    // "ready to accept data" state to make sure we catch the first
    // clock of data of a new packet.
    else begin
      trn_rdst_rdy <= #TCQ 1'b1;
    end
  end
end

//----------------------------------------------------------------------------//
// Create null_mux_sel                                                        //
// null_mux_sel is the signal used to detect a discontinue situation and      //
// mux in the null packet generated in rx_null_gen. Only mux in null data     //
// when not at the beginningof a packet. SOF discontinues do not require      //
// padding, as the whole packet is simply squashed instead.                   //
//----------------------------------------------------------------------------//
always @(posedge user_clk) begin
  if(user_rst) begin
    null_mux_sel <= #TCQ 1'b0;
  end
  else begin
    // NULL packet done
    if(null_mux_sel && null_rx_tlast && m_axis_rx_tready)
    begin
      null_mux_sel <= #TCQ 1'b0;
    end

    // Discontinue detected and we're in packet, so switch to NULL packet
    else if(dsc_flag && !data_hold) begin
      null_mux_sel <= #TCQ 1'b1;
    end
  end
end


//----------------------------------------------------------------------------//
// Create discontinue tracking signals                                        //
//----------------------------------------------------------------------------//
// Create signal trn_in_packet, which is needed to validate trn_rsrc_dsc. We
// should ignore trn_rsrc_dsc when it's asserted out-of-packet.
always @(posedge user_clk) begin
  if(user_rst) begin
    trn_in_packet <= #TCQ 1'b0;
  end
  else begin
    if(trn_rsof && !trn_reof && rsrc_rdy_filtered && trn_rdst_rdy)
    begin
      trn_in_packet <= #TCQ 1'b1;
    end
    else if(trn_rsrc_dsc) begin
      trn_in_packet <= #TCQ 1'b0;
    end
    else if(trn_reof && !trn_rsof && trn_rsrc_rdy && trn_rdst_rdy) begin
      trn_in_packet <= #TCQ 1'b0;
    end
  end
end


// Create dsc_flag, which identifies and stores mid-packet discontinues that
// require null packet padding. This signal is edge sensitive to trn_rsrc_dsc,
// to make sure we don't service the same dsc twice in the event that
// trn_rsrc_dsc stays asserted for longer than it takes to pad out the packet.
assign dsc_detect = trn_rsrc_dsc && !trn_rsrc_dsc_d && trn_in_packet &&
                         (!trn_rsof || trn_reof) && !(trn_rdst_rdy && trn_reof);

always @(posedge user_clk) begin
  if(user_rst) begin
    reg_dsc_detect <= #TCQ 1'b0;
    trn_rsrc_dsc_d <= #TCQ 1'b0;
  end
  else begin
    if(dsc_detect) begin
      reg_dsc_detect <= #TCQ 1'b1;
    end
    else if(null_mux_sel) begin
      reg_dsc_detect <= #TCQ 1'b0;
    end

    trn_rsrc_dsc_d <= #TCQ trn_rsrc_dsc;
  end
end

assign dsc_flag = dsc_detect || reg_dsc_detect;



//----------------------------------------------------------------------------//
// Create np_counter (V6 128-bit only). This counter tells the V6 128-bit     //
// interface core how many NP packets have left the RX pipeline. The V6       //
// 128-bit interface uses this count to perform rnp_ok modulation.            //
//----------------------------------------------------------------------------//
generate
  if(C_FAMILY == "V6" && C_DATA_WIDTH == 128) begin : np_cntr_to_128_enabled
    reg [2:0] reg_np_counter;

    // Look for NP packets beginning on lower (i.e. unaligned) start
    wire mrd_lower      = (!(|m_axis_rx_tdata[92:88]) && !m_axis_rx_tdata[94]);
    wire mrd_lk_lower   = (m_axis_rx_tdata[92:88] == 5'b00001);
    wire io_rdwr_lower  = (m_axis_rx_tdata[92:88] == 5'b00010);
    wire cfg_rdwr_lower = (m_axis_rx_tdata[92:89] == 4'b0010);
    wire atomic_lower   = ((&m_axis_rx_tdata[91:90]) && m_axis_rx_tdata[94]);

    wire np_pkt_lower = (mrd_lower      ||
                         mrd_lk_lower   ||
                         io_rdwr_lower  ||
                         cfg_rdwr_lower ||
                         atomic_lower) && m_axis_rx_tuser[13];

    // Look for NP packets beginning on upper (i.e. aligned) start
    wire mrd_upper      = (!(|m_axis_rx_tdata[28:24]) && !m_axis_rx_tdata[30]);
    wire mrd_lk_upper   = (m_axis_rx_tdata[28:24] == 5'b00001);
    wire io_rdwr_upper  = (m_axis_rx_tdata[28:24] == 5'b00010);
    wire cfg_rdwr_upper = (m_axis_rx_tdata[28:25] == 4'b0010);
    wire atomic_upper   = ((&m_axis_rx_tdata[27:26]) && m_axis_rx_tdata[30]);

    wire np_pkt_upper = (mrd_upper      ||
                         mrd_lk_upper   ||
                         io_rdwr_upper  ||
                         cfg_rdwr_upper ||
                         atomic_upper) && !m_axis_rx_tuser[13];

    wire pkt_accepted =
                    m_axis_rx_tuser[14] && m_axis_rx_tready && m_axis_rx_tvalid;

    // Increment counter whenever an NP packet leaves the RX pipeline
    always @(posedge user_clk)  begin
      if (user_rst) begin
        reg_np_counter <= #TCQ 0;
      end
      else begin
        if((np_pkt_lower || np_pkt_upper) && pkt_accepted)
        begin
          reg_np_counter <= #TCQ reg_np_counter + 3'h1;
        end
      end
    end

    assign np_counter = reg_np_counter;
  end
  else begin : np_cntr_to_128_disabled
    assign np_counter = 3'h0;
  end
endgenerate


endmodule
