Swatantara21/Bulk_Encryptor/Aes-Reorg/bitfilegen/ip/dual_clock_fifo/fifo_generator_0_funcsim.vhdl

-- Copyright 1986-2014 Xilinx, Inc. All Rights Reserved.
-- --------------------------------------------------------------------------------
-- Tool Version: Vivado v.2014.3.1 (lin64) Build 1056140 Thu Oct 30 16:30:39 MDT 2014
-- Date        : Wed Mar 22 04:31:22 2017
-- Host        : AJIT6 running 64-bit Ubuntu 12.04.5 LTS
-- Command     : write_vhdl -force -mode funcsim
--               /home/anshul/Aes-Reorg/bitfilegen/ip/dual_clock_fifo/fifo_generator_0_funcsim.vhdl
-- Design      : fifo_generator_0
-- Purpose     : This VHDL netlist is a functional simulation representation of the design and should not be modified or
--               synthesized. This netlist cannot be used for SDF annotated simulation.
-- Device      : xc7k325tffg900-2
-- --------------------------------------------------------------------------------
library IEEE;
use IEEE.STD_LOGIC_1164.ALL;
library UNISIM;
use UNISIM.VCOMPONENTS.ALL;
entity fifo_generator_0blk_mem_gen_prim_wrapper is
  port (
    dout : out STD_LOGIC_VECTOR ( 63 downto 0 );
    tmp_ram_rd_en : in STD_LOGIC;
    rd_clk : in STD_LOGIC;
    Q : in STD_LOGIC_VECTOR ( 0 to 0 );
    E : in STD_LOGIC_VECTOR ( 0 to 0 );
    wr_clk : in STD_LOGIC;
    O2 : in STD_LOGIC_VECTOR ( 3 downto 0 );
    I1 : in STD_LOGIC_VECTOR ( 3 downto 0 );
    din : in STD_LOGIC_VECTOR ( 63 downto 0 )
  );
  attribute ORIG_REF_NAME : string;
  attribute ORIG_REF_NAME of fifo_generator_0blk_mem_gen_prim_wrapper : entity is "blk_mem_gen_prim_wrapper";
end fifo_generator_0blk_mem_gen_prim_wrapper;

architecture STRUCTURE of fifo_generator_0blk_mem_gen_prim_wrapper is
  signal \n_68_DEVICE_7SERIES.NO_BMM_INFO.SDP.WIDE_PRIM36_NO_ECC.ram\ : STD_LOGIC;
  signal \n_69_DEVICE_7SERIES.NO_BMM_INFO.SDP.WIDE_PRIM36_NO_ECC.ram\ : STD_LOGIC;
  signal \n_70_DEVICE_7SERIES.NO_BMM_INFO.SDP.WIDE_PRIM36_NO_ECC.ram\ : STD_LOGIC;
  signal \n_71_DEVICE_7SERIES.NO_BMM_INFO.SDP.WIDE_PRIM36_NO_ECC.ram\ : STD_LOGIC;
  signal \n_72_DEVICE_7SERIES.NO_BMM_INFO.SDP.WIDE_PRIM36_NO_ECC.ram\ : STD_LOGIC;
  signal \n_73_DEVICE_7SERIES.NO_BMM_INFO.SDP.WIDE_PRIM36_NO_ECC.ram\ : STD_LOGIC;
  signal \n_74_DEVICE_7SERIES.NO_BMM_INFO.SDP.WIDE_PRIM36_NO_ECC.ram\ : STD_LOGIC;
  signal \n_75_DEVICE_7SERIES.NO_BMM_INFO.SDP.WIDE_PRIM36_NO_ECC.ram\ : STD_LOGIC;
  signal \NLW_DEVICE_7SERIES.NO_BMM_INFO.SDP.WIDE_PRIM36_NO_ECC.ram_CASCADEOUTA_UNCONNECTED\ : STD_LOGIC;
  signal \NLW_DEVICE_7SERIES.NO_BMM_INFO.SDP.WIDE_PRIM36_NO_ECC.ram_CASCADEOUTB_UNCONNECTED\ : STD_LOGIC;
  signal \NLW_DEVICE_7SERIES.NO_BMM_INFO.SDP.WIDE_PRIM36_NO_ECC.ram_DBITERR_UNCONNECTED\ : STD_LOGIC;
  signal \NLW_DEVICE_7SERIES.NO_BMM_INFO.SDP.WIDE_PRIM36_NO_ECC.ram_SBITERR_UNCONNECTED\ : STD_LOGIC;
  signal \NLW_DEVICE_7SERIES.NO_BMM_INFO.SDP.WIDE_PRIM36_NO_ECC.ram_ECCPARITY_UNCONNECTED\ : STD_LOGIC_VECTOR ( 7 downto 0 );
  signal \NLW_DEVICE_7SERIES.NO_BMM_INFO.SDP.WIDE_PRIM36_NO_ECC.ram_RDADDRECC_UNCONNECTED\ : STD_LOGIC_VECTOR ( 8 downto 0 );
  attribute BOX_TYPE : string;
  attribute BOX_TYPE of \DEVICE_7SERIES.NO_BMM_INFO.SDP.WIDE_PRIM36_NO_ECC.ram\ : label is "PRIMITIVE";
begin
\DEVICE_7SERIES.NO_BMM_INFO.SDP.WIDE_PRIM36_NO_ECC.ram\: unisim.vcomponents.RAMB36E1
    generic map(
      DOA_REG => 0,
      DOB_REG => 0,
      EN_ECC_READ => false,
      EN_ECC_WRITE => false,
      INITP_00 => X"0000000000000000000000000000000000000000000000000000000000000000",
      INITP_01 => X"0000000000000000000000000000000000000000000000000000000000000000",
      INITP_02 => X"0000000000000000000000000000000000000000000000000000000000000000",
      INITP_03 => X"0000000000000000000000000000000000000000000000000000000000000000",
      INITP_04 => X"0000000000000000000000000000000000000000000000000000000000000000",
      INITP_05 => X"0000000000000000000000000000000000000000000000000000000000000000",
      INITP_06 => X"0000000000000000000000000000000000000000000000000000000000000000",
      INITP_07 => X"0000000000000000000000000000000000000000000000000000000000000000",
      INITP_08 => X"0000000000000000000000000000000000000000000000000000000000000000",
      INITP_09 => X"0000000000000000000000000000000000000000000000000000000000000000",
      INITP_0A => X"0000000000000000000000000000000000000000000000000000000000000000",
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
